radiolok/gps_ocxo/(list of files, drawings)

Other design files:
2x_buffer.dch
buffer.dip
gps.dch
gps.dip
hw/display/display.dch
hw/display/display.dip
hw/legacy/v0.1/gpsdo.dch
hw/legacy/v0.1/gpsdo.dip
hw/legacy/v0.3/2x_buffer.dch
hw/legacy/v0.3/buffer.dip
hw/legacy/v0.3/gps.dch
hw/legacy/v0.3/gps.dip
hw/legacy/v0.3/ocxo.dch
hw/legacy/v0.3/ocxo.dip
hw/legacy/v0.3/pwr_eth.dch
hw/legacy/v0.3/pwr_eth.dip
ocxo.dch
ocxo.dip
pwr_eth.dch
pwr_eth.dip
