radiolok/gps_ocxo/(commit log)

2025-08-11 fix: add 2x buffer
    [2x_buffer.dch, buffer.dip]
2025-08-11 add gps module
    [gps.dch, gps.dip]
2025-08-11 add display module
    [display.dch, display.dip]
2025-08-11 add ocxo module
    [ocxo.dch, ocxo.dip]
2025-08-11 add pwr_eth module
    [pwr_eth.dch, pwr_eth.dip]
2025-08-11 add GPS DO old module
    [gpsdo.dch, gpsdo.dip]
2026-10-04 chore: restructure repo into hw/, fw/, au/
    - hw/display: ILC1-8/7L indicator board
    - hw/legacy/v0.1, v0.3: boards of earlier versions
    - fw/ilc_demo: indicator demo firmware (PlatformIO)
    Claude-Session: https://claude.ai/code/session_01EBFUC52CNqvemQ48pSftEA
    [2x_buffer.dch, buffer.dip, display.dch, display.dip, gps.dch, gps.dip, gpsdo.dch, gpsdo.dip]
2026-10-04 docs: add README, architecture rev. 2 and block diagrams
    - README with project overview, status and layout
    - hw/ARCHITECTURE.md: target architecture (AD9545 disciplining, boards, Zephyr SW, calibration, test stand)
    - hw/img: SVG block diagrams and their generator
    - hw/mcu_eth_gnss: netlist of the MCU+ETH+GNSS board
    - au/: placeholder for submodules
    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
